xtompok/LED_driver/hw/LED_driver_BOM.ods

Component Count: | 96
Ref | Qnty | Value | Cmp name | Footprint | Description | Vendor
C1, C2, C10, C11, C16, C20, C21, C30, C31, C51, C61, C71, C81, | 13 | 100n | C | Capacitor_SMD:C_0603_1608Metric
C4, C7, | 2 | 27p | C | Capacitor_SMD:C_0603_1608Metric
C5, C6, C8, C13, | 4 | 1u | C | Capacitor_SMD:C_0603_1608Metric
C9, | 1 | 10n | C | Capacitor_SMD:C_0603_1608Metric
C12, | 1 | 2u2 | C | Capacitor_SMD:C_0603_1608Metric
D1, | 1 | BZT52C15 | D_Zener | Diode_SMD:D_SOD-123F | Zener diode
D2, | 1 | STPS160A | D_Schottky | Diode_SMD:D_SMA
D3, | 1 | L_U1 | LED | LED_SMD:LED_PLCC-2 | Light emitting diode
D4, | 1 | L_U2 | LED | LED_SMD:LED_PLCC-2 | Light emitting diode
D5, | 1 | L_TX | LED | LED_SMD:LED_PLCC-2 | Light emitting diode
D6, | 1 | L_RX | LED | LED_SMD:LED_PLCC-2 | Light emitting diode
D7, | 1 | L_VCC | LED | LED_SMD:LED_PLCC-2 | Light emitting diode
D8, | 1 | L_12V | LED | LED_SMD:LED_PLCC-2 | Light emitting diode
J1, | 1 | PROG | Conn_01x05 | Connector_Molex:Molex_KK-254_AE-6410-05A_1x05_P2.54mm_Vertical | Generic connector, single row, 01x05, script generated (kicad-library-utils/schlib/autogen/connector/)
J2, | 1 | LED_STRIPS | Conn_02x03_Counter_Clockwise | Connector_Molex:Molex_Micro-Fit_3.0_43045-0600_2x03_P3.00mm_Horizontal | Generic connector, double row, 02x03, counter clockwise pin numbering scheme (similar to DIP packge numbering), script generated (kicad-library-utils/schlib/autogen/connector/)
J3, | 1 | POWER | Conn_01x03 | Connector_Phoenix_MSTB:PhoenixContact_MSTB_2,5_3-GF-5,08_1x03_P5.08mm_Horizontal_ThreadedFlange | Generic connector, single row, 01x03, script generated (kicad-library-utils/schlib/autogen/connector/)
J4, | 1 | SINGLE_POWER | Conn_01x02 | Connector_PinHeader_2.54mm:PinHeader_1x02_P2.54mm_Vertical | Generic connector, single row, 01x02, script generated (kicad-library-utils/schlib/autogen/connector/)
J5, | 1 | RST | Conn_01x02 | Connector_PinHeader_2.54mm:PinHeader_1x02_P2.54mm_Vertical | Generic connector, single row, 01x02, script generated (kicad-library-utils/schlib/autogen/connector/)
J6, | 1 | RS485_1 | Conn_01x03 | LED_driver:PTSA_1.5_3-3.5-Z_1985205 | Generic connector, single row, 01x03, script generated (kicad-library-utils/schlib/autogen/connector/)
J7, | 1 | RS485_2 | Conn_01x03 | LED_driver:PTSA_1.5_3-3.5-Z_1985205 | Generic connector, single row, 01x03, script generated (kicad-library-utils/schlib/autogen/connector/)
J8, | 1 | I2C | Conn_01x04 | Connector_Molex:Molex_KK-254_AE-6410-04A_1x04_P2.54mm_Vertical | Generic connector, single row, 01x04, script generated (kicad-library-utils/schlib/autogen/connector/)
J9, | 1 | BUTTONS | Conn_02x04_Counter_Clockwise | Connector_Molex:Molex_Micro-Fit_3.0_43045-0800_2x04_P3.00mm_Horizontal | Generic connector, double row, 02x04, counter clockwise pin numbering scheme (similar to DIP packge numbering), script generated (kicad-library-utils/schlib/autogen/connector/)
J10, | 1 | ADC_EXT | Conn_01x04 | Connector_Molex:Molex_KK-254_AE-6410-04A_1x04_P2.54mm_Vertical | Generic connector, single row, 01x04, script generated (kicad-library-utils/schlib/autogen/connector/)
J11, | 1 | LED_EN | Conn_01x02 | Connector_PinHeader_2.54mm:PinHeader_1x02_P2.54mm_Vertical | Generic connector, single row, 01x02, script generated (kicad-library-utils/schlib/autogen/connector/)
Q1, | 1 | SE60P20B | Q_PMOS_GSD | Package_TO_SOT_SMD:TO-252-2 | P-MOSFET transistor, gate/source/drain
Q10, Q20, Q30, | 3 | YJD80G06A | Q_NMOS_GSD | Package_TO_SOT_SMD:TO-252-2 | N-MOSFET transistor, gate/source/drain
R1, R2, R6, R7, R12, | 5 | 10k | R | Resistor_SMD:R_0603_1608Metric
R3, | 1 | 1M | R | Resistor_SMD:R_0603_1608Metric
R4, R23, | 2 | 33k | R | Resistor_SMD:R_0603_1608Metric
R5, | 1 | 150k | R | Resistor_SMD:R_0603_1608Metric
R8, R9, R29 | 3 | 1k5 | R | Resistor_SMD:R_0603_1608Metric
R10, R20, R30, | 3 | 100R | R | Resistor_SMD:R_0603_1608Metric
R11, R21, R31, | 3 | 0.01R | R | Resistor_SMD:R_1206_3216Metric
R24, R25, R26, R27, | 4 | 330R | R | Resistor_SMD:R_0603_1608Metric
R28, R51, R61, R71, R81, | 5 | 4k7 | R | Resistor_SMD:R_0603_1608Metric
R32, | 1 | 560R | R | Resistor_SMD:R_0603_1608Metric
R33, R52, R62, R72, R82, | 5 | 1k | R | Resistor_SMD:R_0603_1608Metric
R34, R36, | 2 | 720R | R | Resistor_SMD:R_0603_1608Metric
R35, | 1 | 120R | R | Resistor_SMD:R_0603_1608Metric
TH1, | 1 | NTCC-22k | Thermistor_NTC | Capacitor_THT:C_Disc_D3.8mm_W2.6mm_P2.50mm | Temperature dependent resistor, negative temperature coefficient
U1, | 1 | MIC5504-3.3YM5 | MIC5504-3.3YM5 | Package_TO_SOT_SMD:SOT-23-5 | 300mA Low-dropout Voltage Regulator, Vout 3.3V, Vin up to 5.5V, SOT-23
U2, | 1 | AP2204K-5.0 | AP2204K-5.0 | Package_TO_SOT_SMD:SOT-23-5 | 150mA low dropout linear regulator, wide input voltage range, 5.0V fixed positive output, SOT-23-5 package
U3, | 1 | STM32F030C8Tx | STM32F030C8Tx | Package_QFP:LQFP-48_7x7mm_P0.5mm | ARM Cortex-M0 MCU, 64KB flash, 8KB RAM, 48MHz, 2.4-3.6V, 39 GPIO, LQFP-48
U4, | 1 | BY25Q16BSTIG | AT25xxx | Package_SO:SOP-8_3.9x4.9mm_P1.27mm | Microchip SPI Serial EEPROM, DIP-8/SOIC-8/TSSOP-8
U5, | 1 | SN65HVD3082EDR | MAX485E | Package_SO:SOP-8_3.9x4.9mm_P1.27mm | Half duplex RS-485/RS-422, 2.5 Mbps, ±15kV electro-static discharge (ESD) protection, no slew-rate, no low-power shutdown, with receiver/driver enable, 32 receiver drive kapacitity, DIP-8 and SOIC-8
U10, U20, U30, | 3 | ZXGD3009E6 | ZXGD3009E6 | Package_TO_SOT_SMD:SOT-23-6 | 2A (peak) Gate driver, 40V, SOT-23-6
U11, U21, U31, | 3 | INA180A2 | custom_INA180 | Package_TO_SOT_SMD:SOT-23-5
Y1, | 1 | 8MHz | Crystal | Crystal:Crystal_HC49-U_Vertical | Two pin crystal
