xtompok/LED_driver/hw/LED_driver3/LED_driver3.kicad_pcb

## KiCad design hw/LED_driver3/LED_driver3.kicad_pcb (2024-09-17)

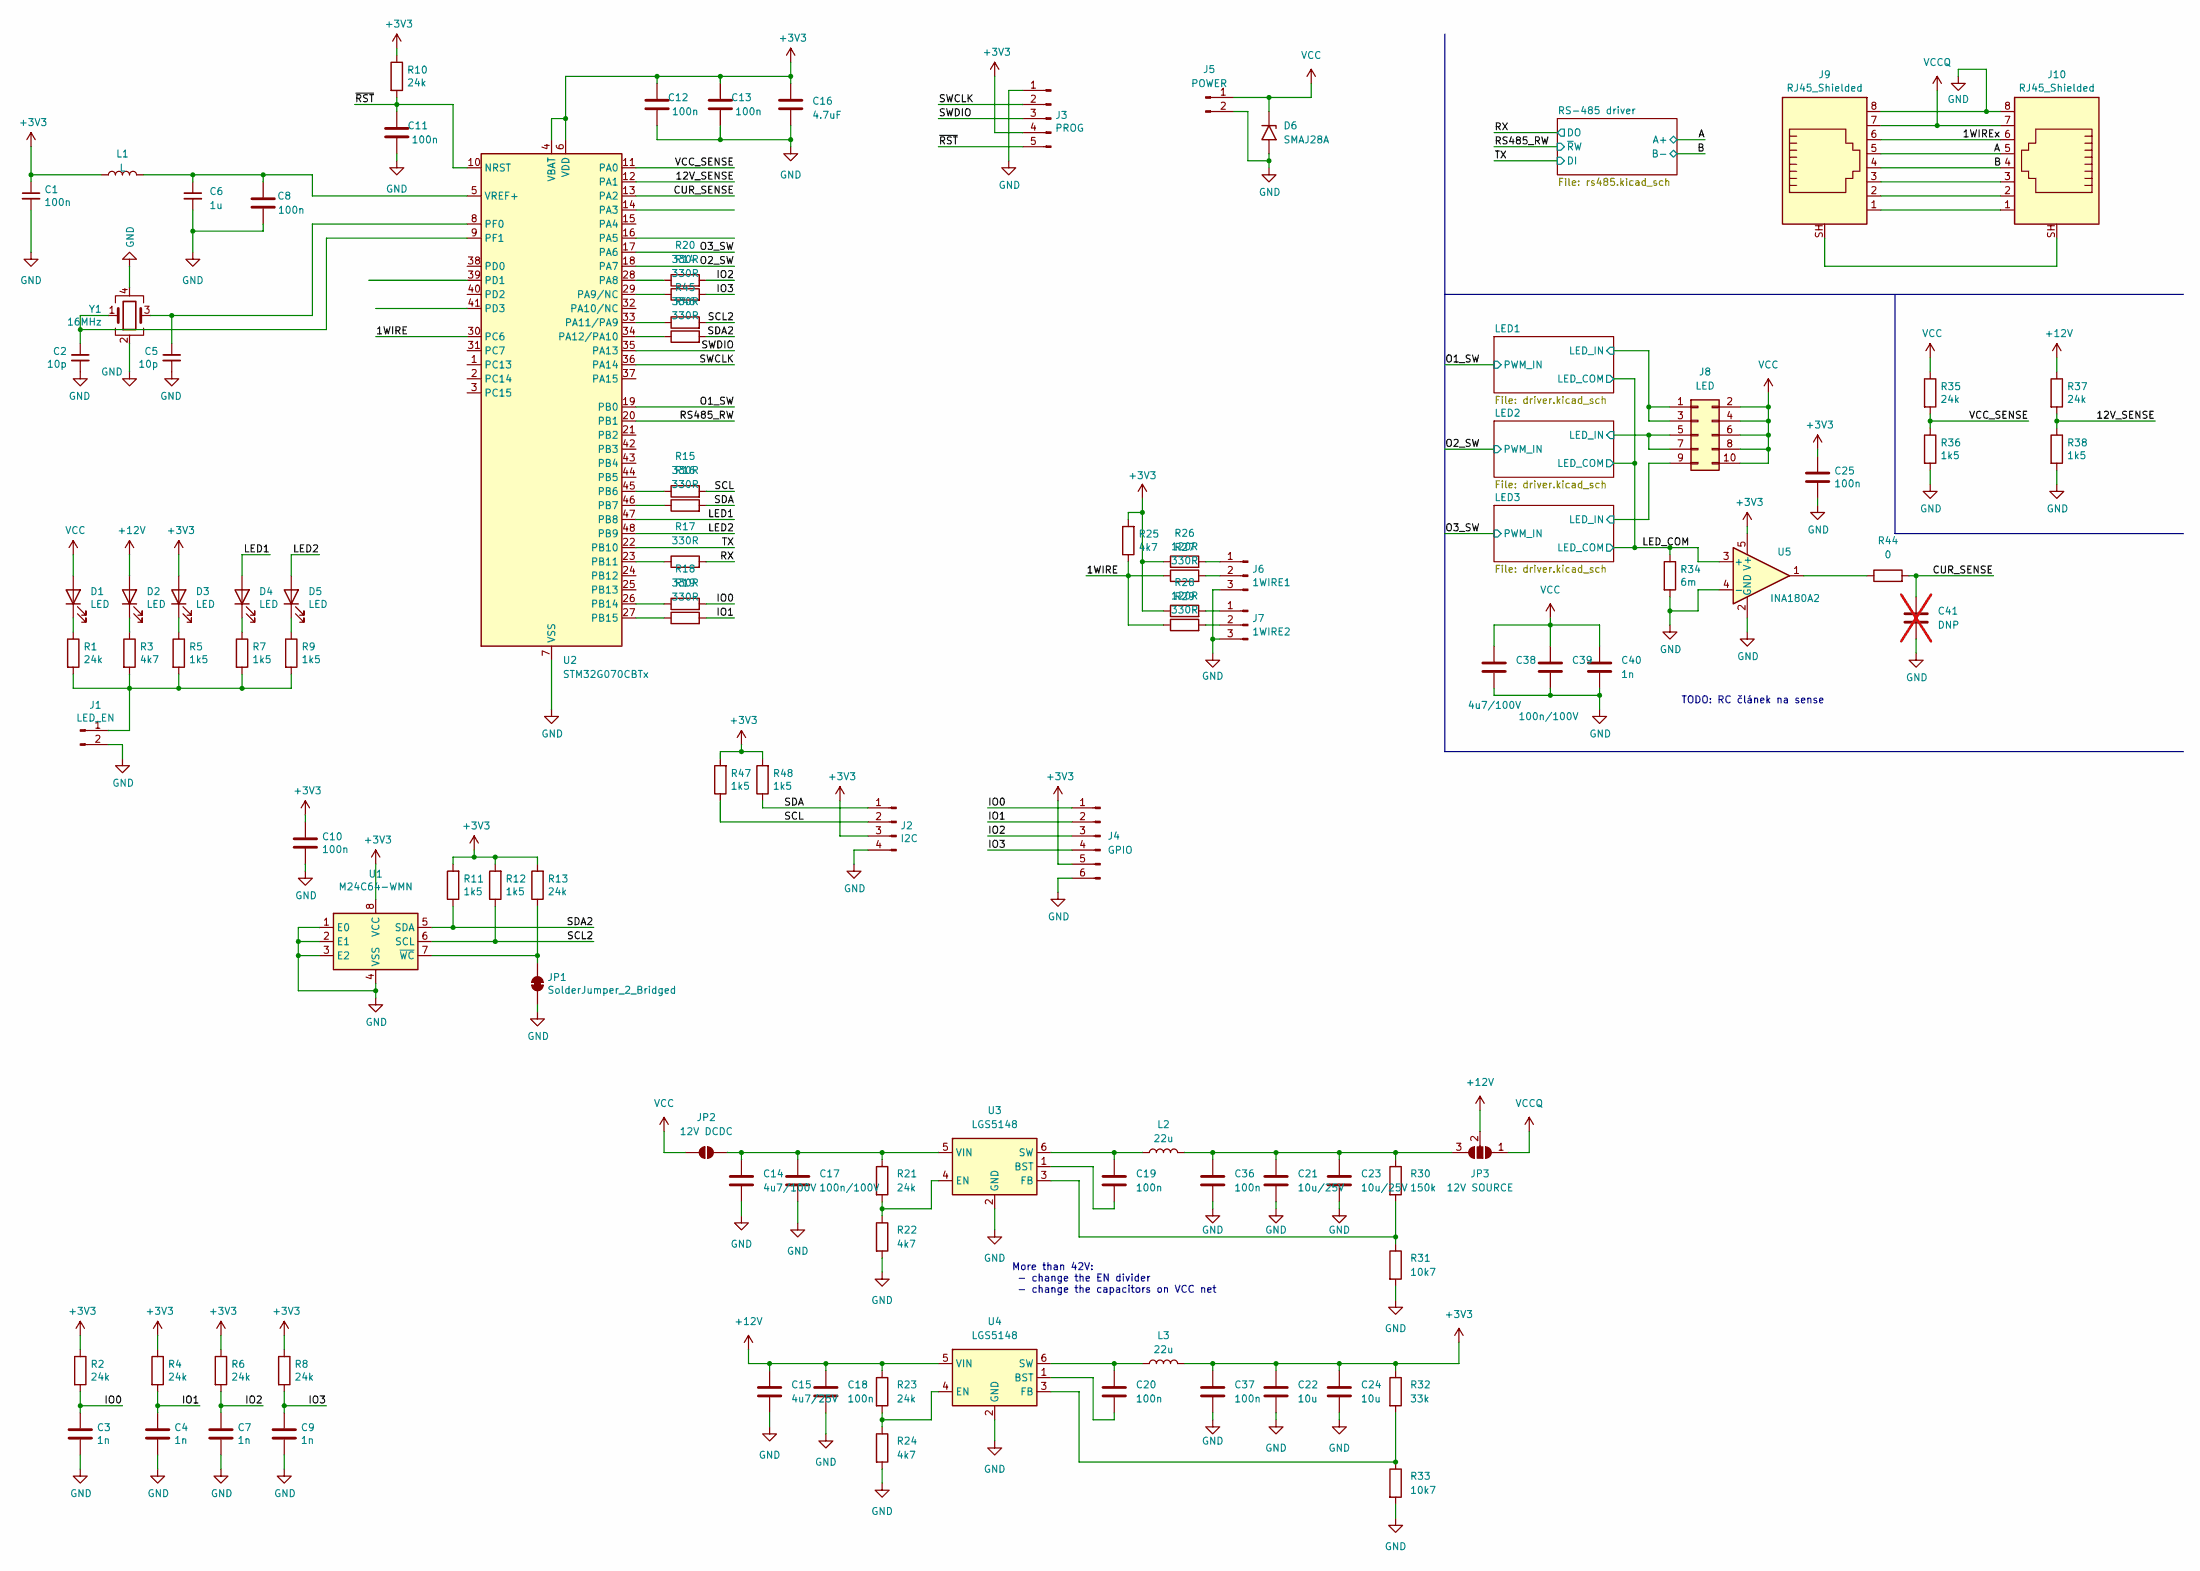
[picture p1: schematic LED_driver3.kicad_sch]

Parts:
C1: 100n; C_0603_1608Metric; Manufacturer_Part_Number CC0603KRX7R9BB104; LCSC C14663
C2, C5: 10p; C_0402_1005Metric; LCSC C32949
C3, C4, C7, C9, C40: 1n; C_0603_1608Metric; LCSC C1588
C6: 1u; C_0805_2012Metric; Manufacturer_Part_Number CL21B105KBFNNNE; LCSC C28323
C8, C10, C11, C12, C13, C18, C19, C20, C25, C36, C37: 100n; C_0603_1608Metric; LCSC C14663
C14, C38: 4u7/100V; C_1206_3216Metric; LCSC C29823
C15: 4u7/25V; C_0805_2012Metric; LCSC C1779
C16: 4.7uF; C_0603_1608Metric; LCSC C19666
C17, C39: 100n/100V; C_0805_2012Metric; LCSC C28233
C21, C23: 10u/25V; C_0805_2012Metric; LCSC C440198
C22, C24: 10u; C_0805_2012Metric; LCSC C440198
C41: DNP; C_0603_1608Metric; not fitted
D1: LED; LED_0603_1608Metric; LCSC C72043
D2, D3, D4, D5: LED; LED_0603_1608Metric
D6: SMAJ28A; D_SMA; LCSC C908775
J1: LED_EN; SolderJumper-2_P1.3mm_Open_TrianglePad1.0x1.5mm
J2: I2C; 15EDGVC-2.5-04P-14
J3: PROG; Molex_KK-254_AE-6410-05A_1x05_P2.54mm_Vertical
J4: GPIO; 15EDGVC-2.5-06P-14
J5: POWER; PhoenixContact_MSTB_2,5_2-GF-5,08_1x02_P5.08mm_Horizontal_T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
J6: 1WIRE1; 15EDGVC-2.5-03P-14
J7: 1WIRE2; 15EDGVC-2.5-03P-14
J8: LED; 15EDGRHCM-THR-3,50-10P-13
J9, J10: RJ45_Shielded; RJJS-88-A22-E1V
JP1: SolderJumper_2_Bridged; SolderJumper-2_P1.3mm_Bridged_Pad1.0x1.5mm
JP2: 12V DCDC; SolderJumper-2_P1.3mm_Open_TrianglePad1.0x1.5mm
JP3: 12V SOURCE; SolderJumper-3_P2.0mm_Open_TrianglePad1.0x1.5mm
L1: L; L_0805_2012Metric; LCSC C88990
L2, L3: 22u; L_Sunlord_SWPA4030S; LCSC C83472
R1, R2, R4, R6, R8, R10, R13, R21, R23, R35, R37: 24k; R_0603_1608Metric; LCSC C23352
R3, R22, R24, R25: 4k7; R_0603_1608Metric; LCSC C23162
R5, R7, R9, R11, R12, R36, R38, R47, R48: 1k5; R_0603_1608Metric; LCSC C22843
R14, R15, R16, R17, R18, R19, R20, R27, R29, R45, R46: 330R; R_0603_1608Metric; LCSC C23138
R26, R28: 120R; R_0603_1608Metric; LCSC C22787
R30: 150k; R_0603_1608Metric
R31, R33: 10k7; R_0603_1608Metric
R32: 33k; R_0603_1608Metric
R34: 6m; R_2512_6332Metric; LCSC C728340
R44: 0; R_0603_1608Metric
U1: M24C64-WMN; SOIC-8_3.9x4.9mm_P1.27mm; LCSC C79988
U2: STM32G070CBTx; LQFP-48_7x7mm_P0.5mm; LCSC C529338
U3, U4: LGS5148; SOT-23-6
U5: INA180A2; SOT-23-5; LCSC C192764
Y1: 16MHz; Crystal_SMD_3225-4Pin_3.2x2.5mm; LCSC C13738

Connections:
+3V3: C1.1, C10.1, C12.1, C13.1, C16.1, C22.1, C24.1, C25.1, C37.1, D3.2 (A), J2.3, J3.4, J4.5, L1.1, L3.2, R2.1, R4.1, R6.1, R8.1, R10.1, R11.2, R12.2, R13.2, R25.2, R26.1, R28.1, R32.1, R47.2, R48.2, U1.8 (VCC), U2.4 (VBAT), U2.6 (VDD), U5.5 (V+); also elsewhere on the board
+12V: C15.1, C18.1, D2.2 (A), JP3.2 (C), R23.1, R37.1, U4.5 (VIN); also elsewhere on the board
/1WIRE: R25.1, R27.1, R29.1, U2.30 (PC6)
/1WIREx: J9.6, J10.6
/12V_SENSE: R37.2, R38.1, U2.12 (PA1)
/A: J9.5, J10.5; also elsewhere on the board
/B: J9.4, J10.4; also elsewhere on the board
/CUR_SENSE: C41.1, R44.2, U2.13 (PA2)
/IO0: C3.2, J4.1, R2.2, R18.2
/IO1: C4.2, J4.2, R4.2, R19.2
/IO2: C7.2, J4.3, R6.2, R20.2
/IO3: C9.2, J4.4, R8.2, R14.2
/LED1: D4.2 (A), U2.47 (PB8)
/LED1/LED_IN: J8.1, J8.3; also elsewhere on the board
/LED2: D5.2 (A), U2.48 (PB9)
/LED2/LED_IN: J8.5, J8.7; also elsewhere on the board
/LED3/LED_IN: J8.9; also elsewhere on the board
/LED_COM: R34.1, U5.3 (+); also elsewhere on the board
/O1_SW: U2.19 (PB0); also elsewhere on the board
/O2_SW: U2.18 (PA7); also elsewhere on the board
/O3_SW: U2.17 (PA6); also elsewhere on the board
/RS485_RW: U2.20 (PB1); also elsewhere on the board
/RX: R17.2; also elsewhere on the board
/SCL: J2.2, R15.2, R47.1
/SCL2: R12.1, R45.2, U1.6 (SCL)
/SDA: J2.1, R16.2, R48.1
/SDA2: R11.1, R46.2, U1.5 (SDA)
/SWCLK: J3.2, U2.36 (PA14)
/SWDIO: J3.3, U2.35 (PA13)
/TX: U2.22 (PB10); also elsewhere on the board
/VCC_SENSE: R35.2, R36.1, U2.11 (PA0)
/~RST: C11.1, J3.5, R10.2, U2.10 (NRST)
GND: C1.2, C2.2, C3.1, C4.1, C5.2, C6.2, C7.1, C8.2, C9.1, C10.2, C11.2, C12.2, C13.2, C14.2, C15.2, C16.2, C17.2, C18.2, C21.2, C22.2, C23.2, C24.2, C25.2, C36.2, C37.2, C38.2, C39.2, C40.2, C41.2, D6.2 (A2), J1.2, J2.4, J3.1, J4.6, J5.2, J6.3, J7.3, J9.8, J10.8, JP1.2 (B), R22.2, R24.2, R31.2, R33.2, R34.2, R36.2, R38.2, U1.1 (E0), U1.2 (E1), U1.3 (E2), U1.4 (VSS), U2.7 (VSS), U3.2 (GND), U4.2 (GND), U5.2 (GND), U5.4 (-), Y1.2, Y1.4; also elsewhere on the board
unnamed: D1.1 (K), R1.1
unnamed: D2.1 (K), R3.1
unnamed: D3.1 (K), R5.1
unnamed: D4.1 (K), R7.1
unnamed: D5.1 (K), R9.1
unnamed: J1.1, R1.2, R3.2, R5.2, R7.2, R9.2
unnamed: J6.1, R26.2
unnamed: J6.2, R27.2
unnamed: J7.1, R28.2
unnamed: J7.2, R29.2
unnamed: J9.1, J10.1
unnamed: J9.2, J10.2
unnamed: J9.3, J10.3
unnamed: J9.SH, J10.SH
unnamed: JP1.1 (A), R13.1, U1.7 (~WC)
unnamed: C14.1, C17.1, JP2.2 (B), R21.1, U3.5 (VIN)
unnamed: C21.1, C23.1, C36.1, JP3.3 (B), L2.2, R30.1
unnamed: R44.1, U5.1
unnamed: R20.1, U2.28 (PA8)
unnamed: R14.1, U2.29 (PA9/NC)
unnamed: R45.1, U2.33 (PA11/PA9)
unnamed: R46.1, U2.34 (PA12/PA10)
unnamed: R15.1, U2.45 (PB6)
unnamed: R16.1, U2.46 (PB7)
unnamed: R17.1, U2.23 (PB11)
unnamed: R18.1, U2.26 (PB14)
unnamed: R19.1, U2.27 (PB15)
unnamed: C5.1, U2.8 (PF0), Y1.3
unnamed: C2.1, U2.9 (PF1), Y1.1
unnamed: C6.1, C8.1, L1.2, U2.5 (VREF+)
unnamed: C19.2, U3.1 (BST)
unnamed: R21.2, R22.1, U3.4 (EN)
unnamed: R30.2, R31.1, U3.3 (FB)
unnamed: C19.1, L2.1, U3.6 (SW)
unnamed: C20.2, U4.1 (BST)
unnamed: R23.2, R24.1, U4.4 (EN)
unnamed: R32.2, R33.1, U4.3 (FB)
unnamed: C20.1, L3.1, U4.6 (SW)
VCC: C38.1, C39.1, C40.1, D1.2 (A), D6.1 (A1), J5.1, J8.2, J8.4, J8.6, J8.8, J8.10, JP2.1 (A), R35.1; also elsewhere on the board
VCCQ: J9.7, J10.7, JP3.1 (A)

Notes on the sheet:
More than 42V: - change the EN divider - change the capacitors on VCC net
TODO: RC článek na sense

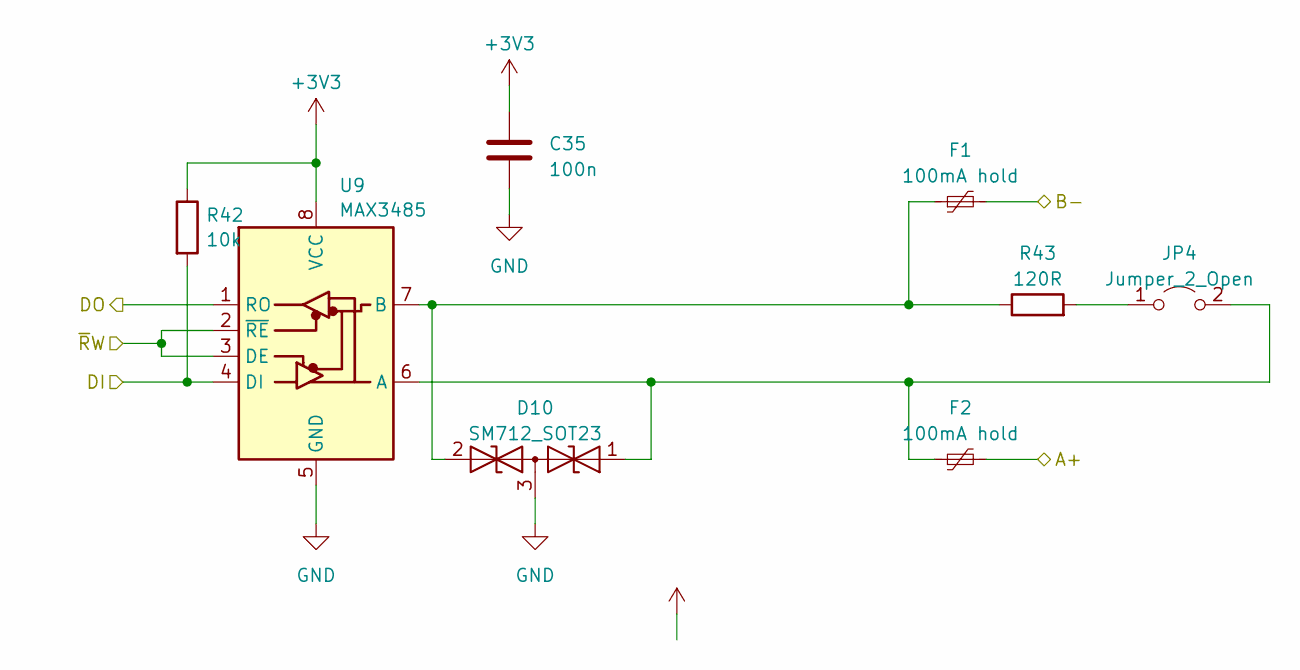
[picture p2: schematic rs485.kicad_sch]

Parts:
C35: 100n; C_0603_1608Metric; LCSC C14663
D10: SM712_SOT23; SOT-23; LCSC C404012
F1, F2: 100mA hold; Fuse_1206_3216Metric; LCSC C70065
JP4: Jumper_2_Open; SolderJumper-2_P1.3mm_Open_TrianglePad1.0x1.5mm; LCSC XXXX
R42: 10k; R_0603_1608Metric; LCSC C25804
R43: 120R; R_0603_1608Metric; LCSC C22787
U9: MAX3485; SOIC-8_3.9x4.9mm_P1.27mm; LCSC C8963

Connections:
+3V3: C35.1, R42.1, U9.8 (VCC); also elsewhere on the board
/A: F2.2; also elsewhere on the board
/B: F1.2; also elsewhere on the board
/RS485_RW: U9.2 (~RE), U9.3 (DE); also elsewhere on the board
/RX: U9.1 (RO); also elsewhere on the board
/TX: R42.2, U9.4 (DI); also elsewhere on the board
GND: C35.2, D10.3 (common), U9.5 (GND); also elsewhere on the board
unnamed: D10.1 (A1), F2.1, JP4.2 (B), U9.6 (A)
unnamed: D10.2 (A2), F1.1, R43.1, U9.7 (B)
unnamed: JP4.1 (A), R43.2

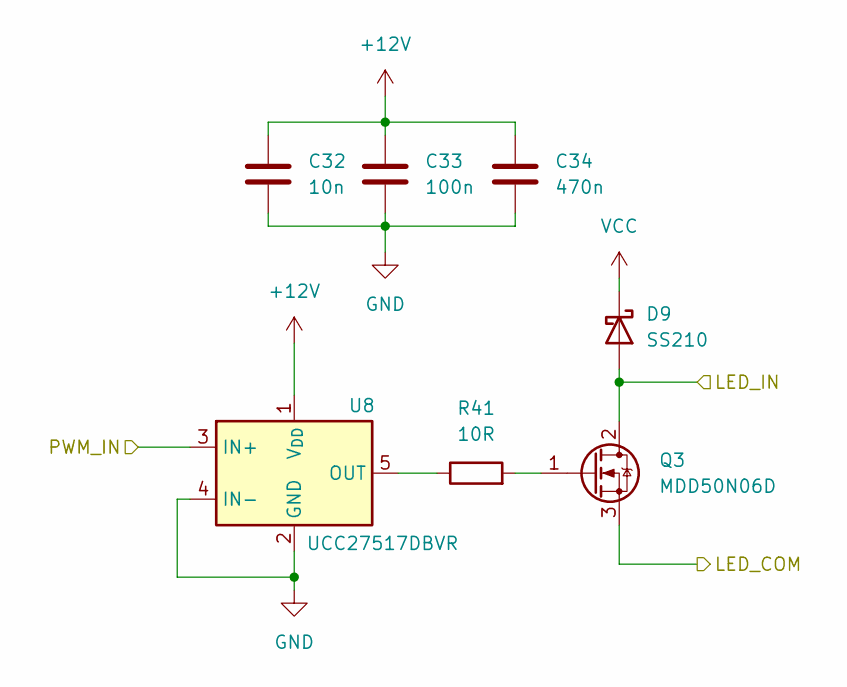
[picture p3: schematic driver.kicad_sch]

Parts:
C32: 10n; C_0603_1608Metric; LCSC C57112
C33: 100n; C_0603_1608Metric; LCSC C14663
C34: 470n; C_0603_1608Metric; LCSC C1623
D9: SS210; D_SMA; LCSC C14996
Q3: MDD50N06D; TO-252-2; LCSC C99395
R41: 10R; R_0603_1608Metric; LCSC C22859
U8: UCC27517DBVR; SOT-23-5

Connections:
+12V: C32.1, C33.1, C34.1, U8.1 (V_{DD}); also elsewhere on the board
/LED3/LED_IN: D9.2 (A), Q3.2 (D); also elsewhere on the board
/LED_COM: Q3.3 (S); also elsewhere on the board
/O3_SW: U8.3 (IN+); also elsewhere on the board
GND: C32.2, C33.2, C34.2, U8.2 (GND), U8.4 (IN-); also elsewhere on the board
unnamed: Q3.1 (G), R41.2
unnamed: R41.1, U8.5 (OUT)
VCC: D9.1 (K); also elsewhere on the board

Parts of its further copies:
C26, C29: 10n; C_0603_1608Metric; LCSC C57112
C27, C30: 100n; C_0603_1608Metric; LCSC C14663
C28, C31: 470n; C_0603_1608Metric; LCSC C1623
D7, D8: SS210; D_SMA; LCSC C14996
Q1, Q2: MDD50N06D; TO-252-2; LCSC C99395
R39, R40: 10R; R_0603_1608Metric; LCSC C22859
U6, U7: UCC27517DBVR; SOT-23-5

Connections of its further copies:
+12V: C26.1, C27.1, C28.1, C29.1, C30.1, C31.1, U6.1 (V_{DD}), U7.1 (V_{DD}); also elsewhere on the board
/LED1/LED_IN: D7.2 (A), Q1.2 (D); also elsewhere on the board
/LED2/LED_IN: D8.2 (A), Q2.2 (D); also elsewhere on the board
/LED_COM: Q1.3 (S), Q2.3 (S); also elsewhere on the board
/O1_SW: U6.3 (IN+); also elsewhere on the board
/O2_SW: U7.3 (IN+); also elsewhere on the board
GND: C26.2, C27.2, C28.2, C29.2, C30.2, C31.2, U6.2 (GND), U6.4 (IN-), U7.2 (GND), U7.4 (IN-); also elsewhere on the board
unnamed: Q1.1 (G), R39.2
unnamed: Q2.1 (G), R40.2
unnamed: R39.1, U6.5 (OUT)
unnamed: R40.1, U7.5 (OUT)
VCC: D7.1 (K), D8.1 (K); also elsewhere on the board

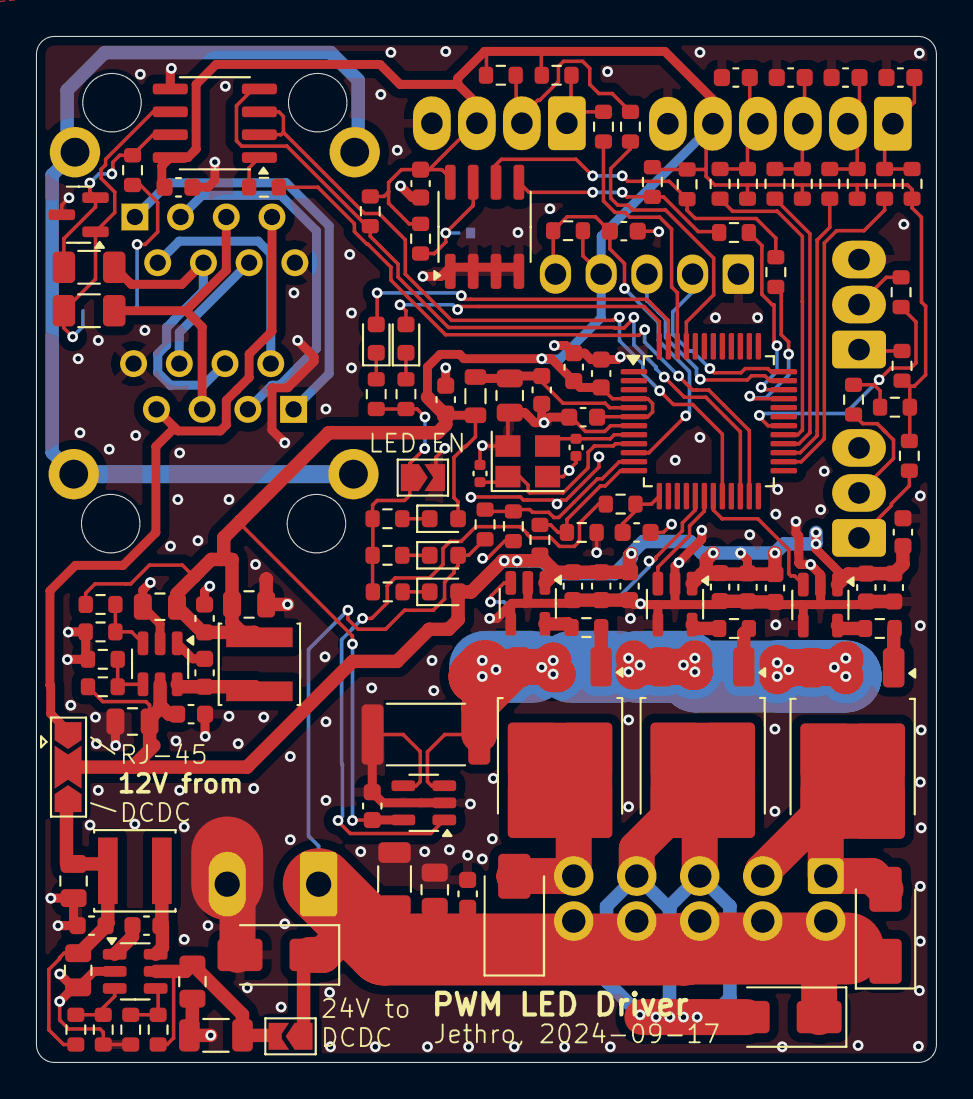
[picture p4: board LED_driver3.kicad_pcb from above]

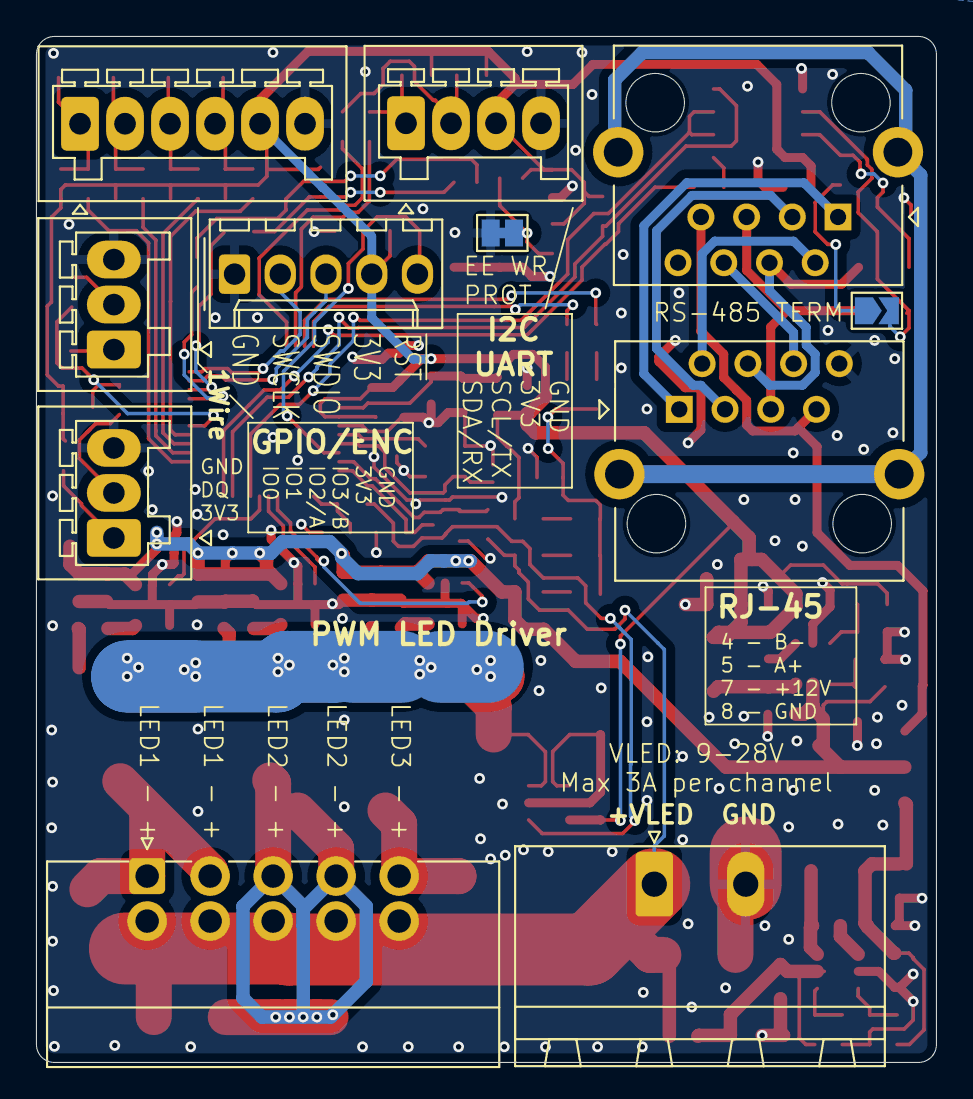
[picture p5: board LED_driver3.kicad_pcb from below]

Board: 2 copper layers, 50.0 x 57.0 mm, 131 parts (11 on the bottom side), 82 nets.
