xtompok/LED_driver/hw/LED_driver2/LED_driver2.kicad_pcb

## KiCad design hw/LED_driver2/LED_driver2.kicad_pcb (2021-05-24)

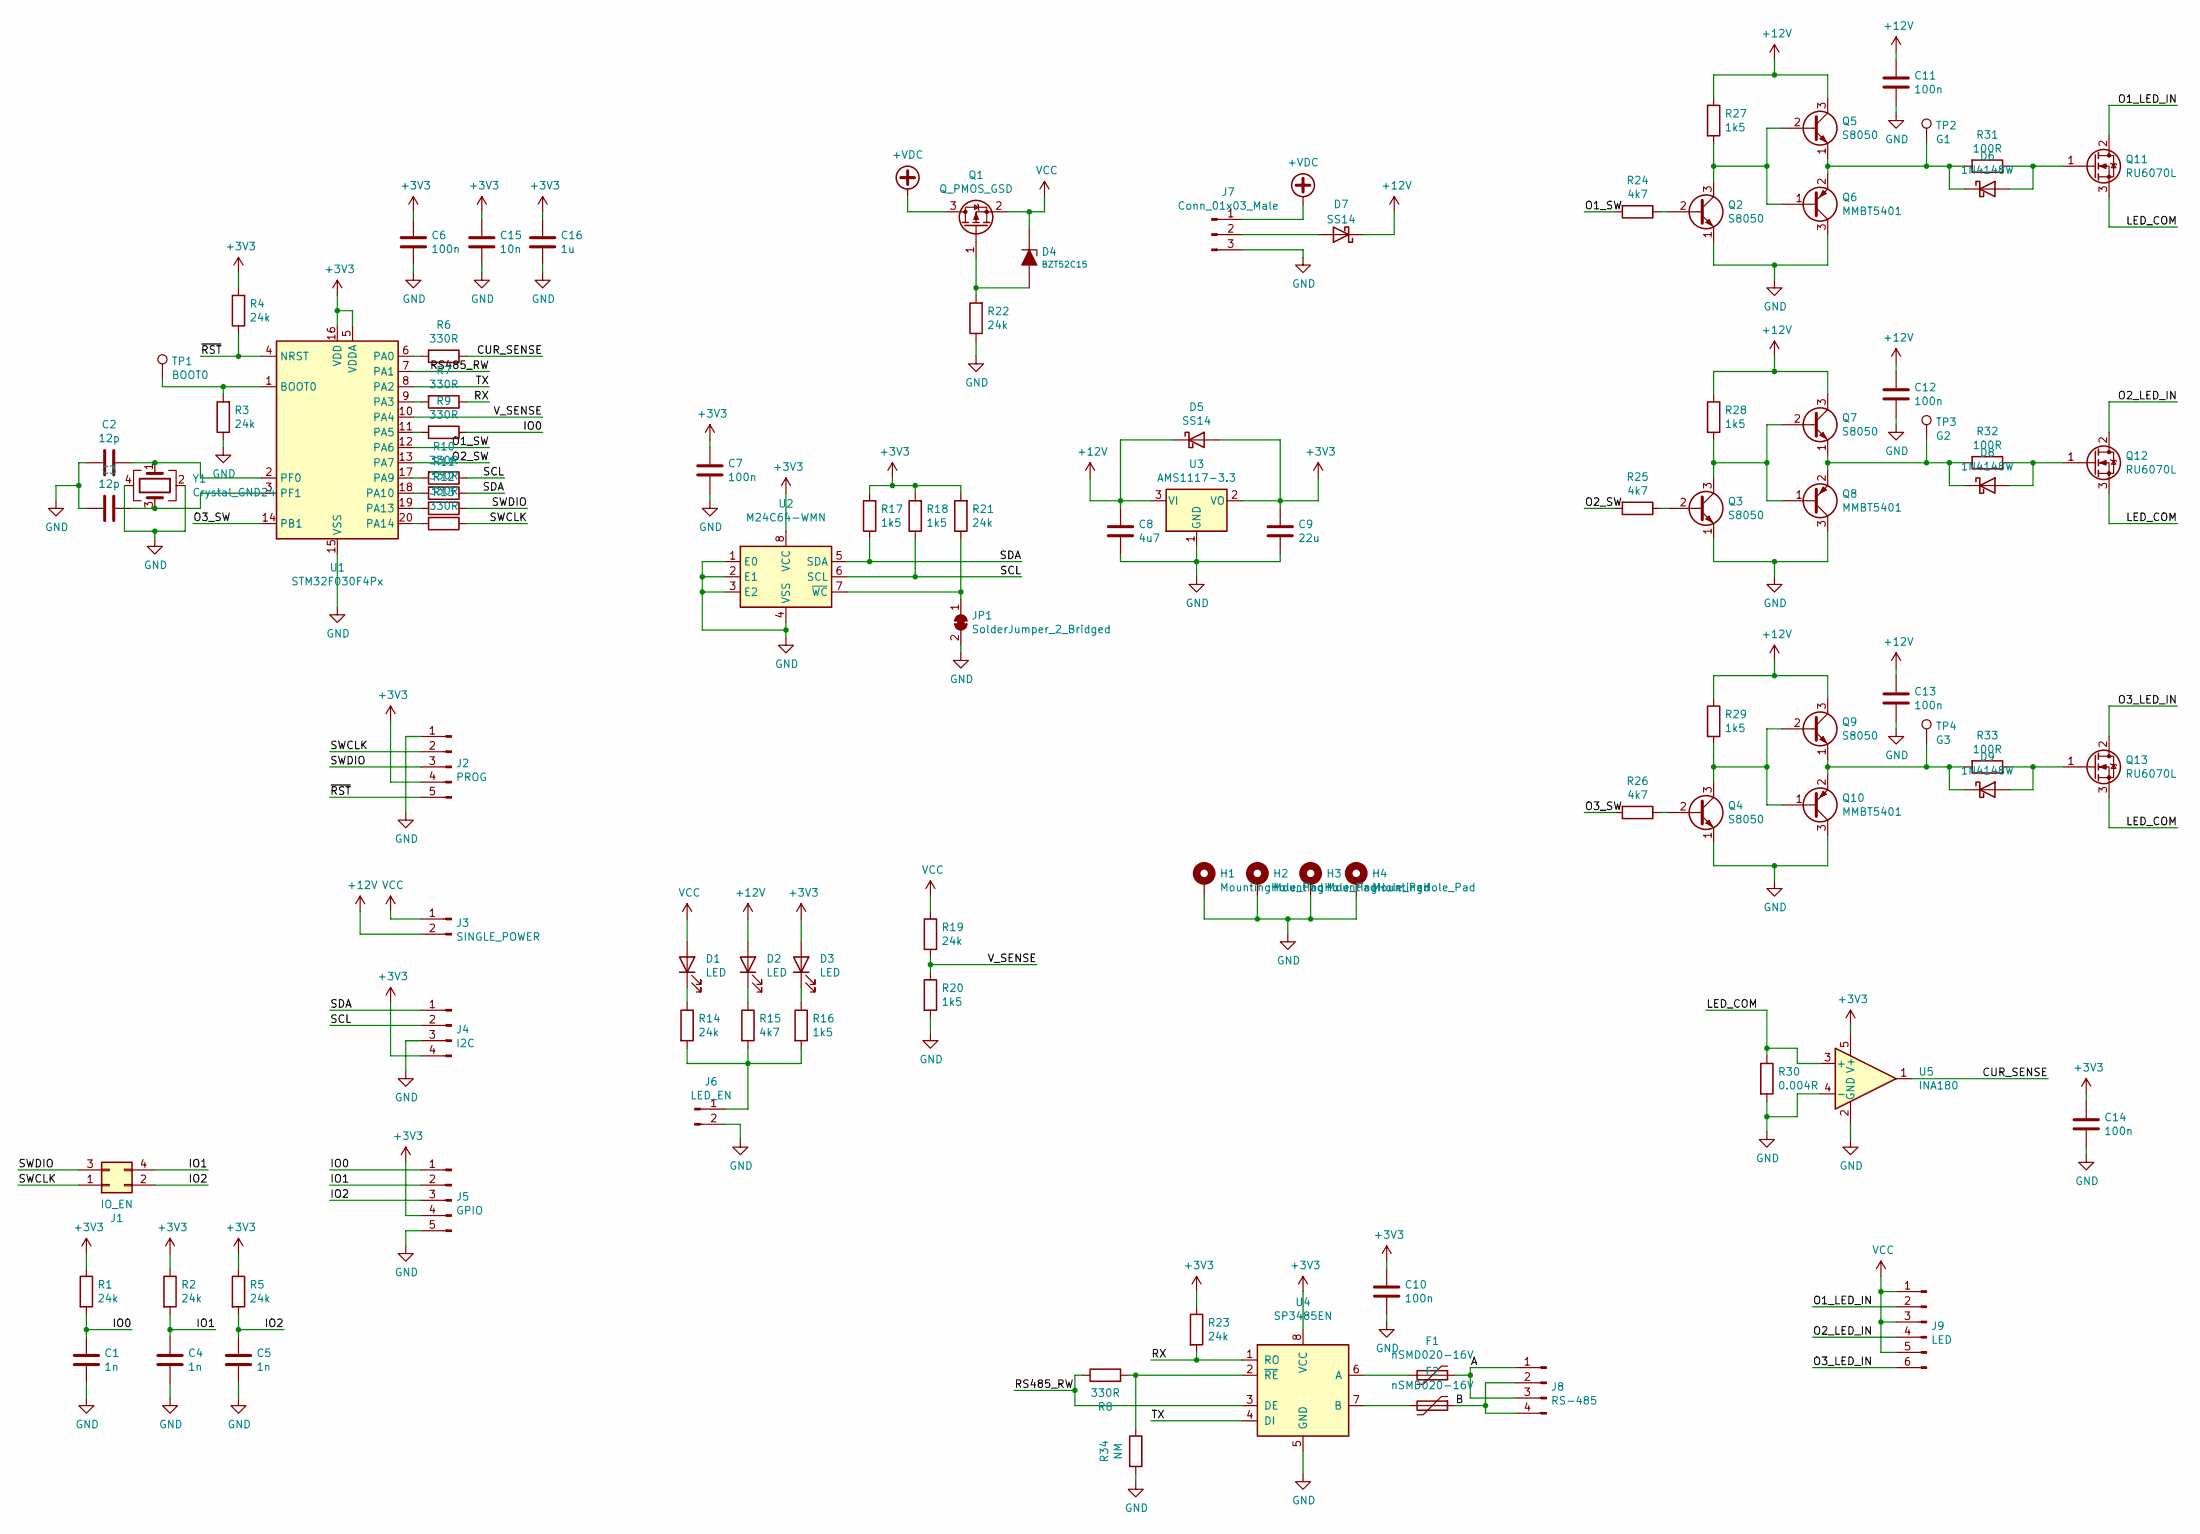
[picture p6: schematic LED_driver2.sch]

Parts:
C1: 1n; C_0603_1608Metric; LCSC C1588
C2: 12p; C_0603_1608Metric; LCSC C38523
C3: 12p; C_0603_1608Metric
C4, C5: 1n; C_0603_1608Metric
C6, C7, C10: 100n; C_0603_1608Metric
C8: 4u7; C_0603_1608Metric; LCSC C19666
C9: 22u; C_0603_1608Metric; LCSC C59461
C11: 100n; R_0603_1608Metric; LCSC C14663
C12, C13: 100n; R_0603_1608Metric
C14: 100n; C_0603_1608Metric; LCSC C14663
C15: 10n; C_0603_1608Metric; LCSC C57112
C16: 1u; C_0603_1608Metric; LCSC C15849
D1: LED; LED_0603_1608Metric; LCSC C72043
D2, D3: LED; LED_0603_1608Metric
D4: BZT52C15; D_SOD-123
D5: SS14; D_SMA
D6, D8, D9: 1N4148W; D_SOD-123; LCSC C81598
D7: SS14; D_SMA; LCSC C2480
F1, F2: nSMD020-16V; Fuse_1206_3216Metric
H1, H2, H3, H4: MountingHole_Pad; MountingHole_3.2mm_M3_Pad_Via
J1: IO_EN; PinHeader_2x02_P2.54mm_Vertical
J2: PROG; Molex_KK-254_AE-6410-05A_1x05_P2.54mm_Vertical
J3: SINGLE_POWER; PinHeader_2x01_P2.54mm_Vertical
J4: I2C; Molex_KK-254_AE-6410-04A_1x04_P2.54mm_Vertical
J5: GPIO; PTSA_1.5_5-3.5-Z_1985221
J6: LED_EN; PinHeader_1x02_P2.54mm_Vertical
J7: Conn_01x03_Male; PhoenixContact_MSTB_2,5_3-GF-5,08_1x03_P5.08mm_Horizontal_T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
J8: RS-485; PTSA_1.5_4-3.5-Z-1985218
J9: LED; PTSA_1.5_6-3.5-Z-1985234
JP1: SolderJumper_2_Bridged; SolderJumper-2_P1.3mm_Bridged_Pad1.0x1.5mm
Q1: Q_PMOS_GSD; TO-252-2
Q2, Q3, Q5, Q7, Q9: S8050; SOT-23
Q4: S8050; SOT-23; LCSC C2146
Q6, Q8: MMBT5401; SOT-23
Q10: MMBT5401; SOT-23; LCSC C8326
Q11, Q12, Q13: RU6070L; TO-252-2
R1, R2, R3, R5, R14, R19, R21, R22, R23: 24k; R_0603_1608Metric
R4: 24k; R_0603_1608Metric; LCSC C23352
R6: 330R; R_0603_1608Metric; LCSC C23138
R7, R8, R9, R10, R11, R12, R13: 330R; R_0603_1608Metric
R15, R25, R26: 4k7; R_0603_1608Metric
R16, R18, R20, R27, R28, R29: 1k5; R_0603_1608Metric
R17: 1k5; R_0603_1608Metric; LCSC C22843
R24: 4k7; R_0603_1608Metric; LCSC C23162
R30: 0.004R; R_2512_6332Metric
R31: 100R; R_0603_1608Metric; LCSC C22775
R32, R33: 100R; R_0603_1608Metric
R34: NM; R_0603_1608Metric
TP1: BOOT0; TestPoint_THTPad_D2.0mm_Drill1.0mm
TP2: G1; TestPoint_THTPad_D1.0mm_Drill0.5mm
TP3: G2; TestPoint_THTPad_D1.0mm_Drill0.5mm
TP4: G3; TestPoint_THTPad_D1.0mm_Drill0.5mm
U1: STM32F030F4Px; TSSOP-20_4.4x6.5mm_P0.65mm
U2: M24C64-WMN; SOIC-8_3.9x4.9mm_P1.27mm; LCSC C79988
U3: AMS1117-3.3; SOT-223-3_TabPin2; LCSC C6186
U4: SP3485EN; SOIC-8_3.9x4.9mm_P1.27mm; LCSC C8963
U5: INA180; SOT-23-5
Y1: Crystal_GND24; Crystal_SMD_3225-4Pin_3.2x2.5mm; LCSC C13738

Connections:
+3V3: C6.1, C7.1, C9.1, C10.1, C14.1, C15.1, C16.1, D3.2 (A), D5.2 (A), J2.4, J4.4, J5.4, R1.1, R2.1, R4.2, R5.1, R17.2, R18.2, R21.2, R23.1, U1.5 (VDDA), U1.16 (VDD), U2.8 (VCC), U3.2 (VO), U4.8 (VCC), U5.5 (V+)
+12V: C8.1, C11.1, C12.1, C13.1, D2.2 (A), D5.1 (K), D7.1 (K), J3.2, Q5.3 (C), Q7.3 (C), Q9.3 (C), R27.1, R28.1, R29.1, U3.3 (VI)
+VDC: J7.1, Q1.3 (D)
/A: F1.1, J8.1, J8.3
/B: F2.1, J8.2, J8.4
/CUR_SENSE: R6.1, U5.1
/IO0: C1.2, J5.1, R1.2, R9.1
/IO1: C4.2, J1.4, J5.2, R2.2
/IO2: C5.2, J1.2, J5.3, R5.2
/LED_COM: Q11.3 (S), Q12.3 (S), Q13.3 (S), R30.1, U5.3 (+)
/O1_LED_IN: J9.2, Q11.2 (D)
/O1_SW: R24.2, U1.12 (PA6)
/O2_LED_IN: J9.4, Q12.2 (D)
/O2_SW: R25.2, U1.13 (PA7)
/O3_LED_IN: J9.6, Q13.2 (D)
/O3_SW: R26.2, U1.14 (PB1)
/RS485_RW: R8.1, U1.7 (PA1), U4.3 (DE)
/RX: R7.1, R23.2, U4.1 (RO)
/SCL: J4.2, R10.1, R18.1, U2.6 (SCL)
/SDA: J4.1, R11.1, R17.1, U2.5 (SDA)
/SWCLK: J1.1, J2.2, R13.1
/SWDIO: J1.3, J2.3, R12.1
/TX: U1.8 (PA2), U4.4 (DI)
/V_SENSE: R19.2, R20.1, U1.10 (PA4)
/~RST: J2.5, R4.1, U1.4 (NRST)
GND: C1.1, C2.2, C3.2, C4.1, C5.1, C6.2, C7.2, C8.2, C9.2, C10.2, C11.2, C12.2, C13.2, C14.2, C15.2, C16.2, H1.1, H2.1, H3.1, H4.1, J2.1, J4.3, J5.5, J6.2, J7.3, JP1.2 (B), Q2.1 (E), Q3.1 (E), Q4.1 (E), Q6.3 (C), Q8.3 (C), Q10.3 (C), R3.1, R20.2, R22.1, R30.2, R34.2, U1.15 (VSS), U2.1 (E0), U2.2 (E1), U2.3 (E2), U2.4 (VSS), U3.1 (GND), U4.5 (GND), U5.2 (GND), U5.4 (-), Y1.2, Y1.4
unnamed: C2.1, U1.2 (PF0), Y1.1
unnamed: C3.1, U1.3 (PF1), Y1.3
unnamed: D1.1 (K), R14.1
unnamed: D2.1 (K), R15.1
unnamed: D3.1 (K), R16.1
unnamed: D4.1 (A), Q1.1 (G), R22.2
unnamed: D6.1 (K), Q5.1 (E), Q6.2 (E), R31.2, TP2.1
unnamed: D6.2 (A), Q11.1 (G), R31.1
unnamed: D7.2 (A), J7.2
unnamed: D8.1 (K), Q7.1 (E), Q8.2 (E), R32.2, TP3.1
unnamed: D8.2 (A), Q12.1 (G), R32.1
unnamed: D9.1 (K), Q9.1 (E), Q10.2 (E), R33.2, TP4.1
unnamed: D9.2 (A), Q13.1 (G), R33.1
unnamed: F1.2, U4.6 (A)
unnamed: F2.2, U4.7 (B)
unnamed: J6.1, R14.2, R15.2, R16.2
unnamed: JP1.1 (A), R21.1, U2.7 (~WC)
unnamed: Q2.2 (B), R24.1
unnamed: Q2.3 (C), Q5.2 (B), Q6.1 (B), R27.2
unnamed: Q3.2 (B), R25.1
unnamed: Q3.3 (C), Q7.2 (B), Q8.1 (B), R28.2
unnamed: Q4.2 (B), R26.1
unnamed: Q4.3 (C), Q9.2 (B), Q10.1 (B), R29.2
unnamed: R3.2, TP1.1, U1.1 (BOOT0)
unnamed: R6.2, U1.6 (PA0)
unnamed: R7.2, U1.9 (PA3)
unnamed: R9.2, U1.11 (PA5)
unnamed: R10.2, U1.17 (PA9)
unnamed: R11.2, U1.18 (PA10)
unnamed: R12.2, U1.19 (PA13)
unnamed: R13.2, U1.20 (PA14)
unnamed: R8.2, R34.1, U4.2 (~RE~)
VCC: D1.2 (A), D4.2 (K), J3.1, J9.1, J9.3, J9.5, Q1.2 (S), R19.1

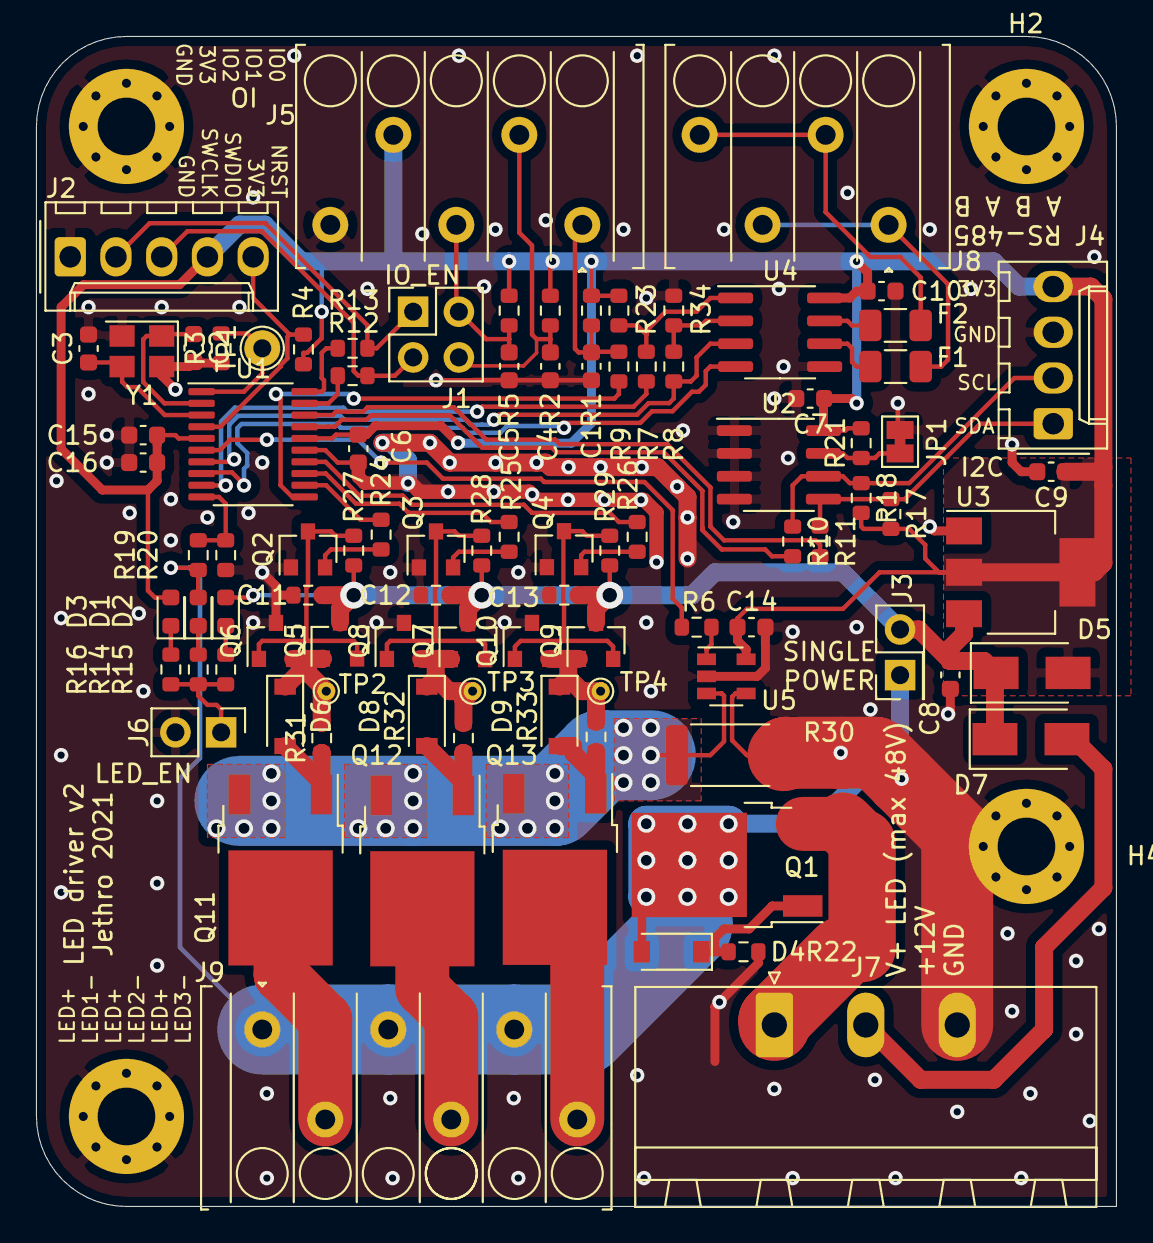
[picture p7: board LED_driver2.kicad_pcb from above]

Board: 2 copper layers, 60.0 x 65.0 mm, 98 parts (0 on the bottom side), 59 nets.
