xtompok/LED_driver/hw/LED_driver.kicad_pcb

## KiCad design hw/LED_driver.kicad_pcb (2020-03-21)

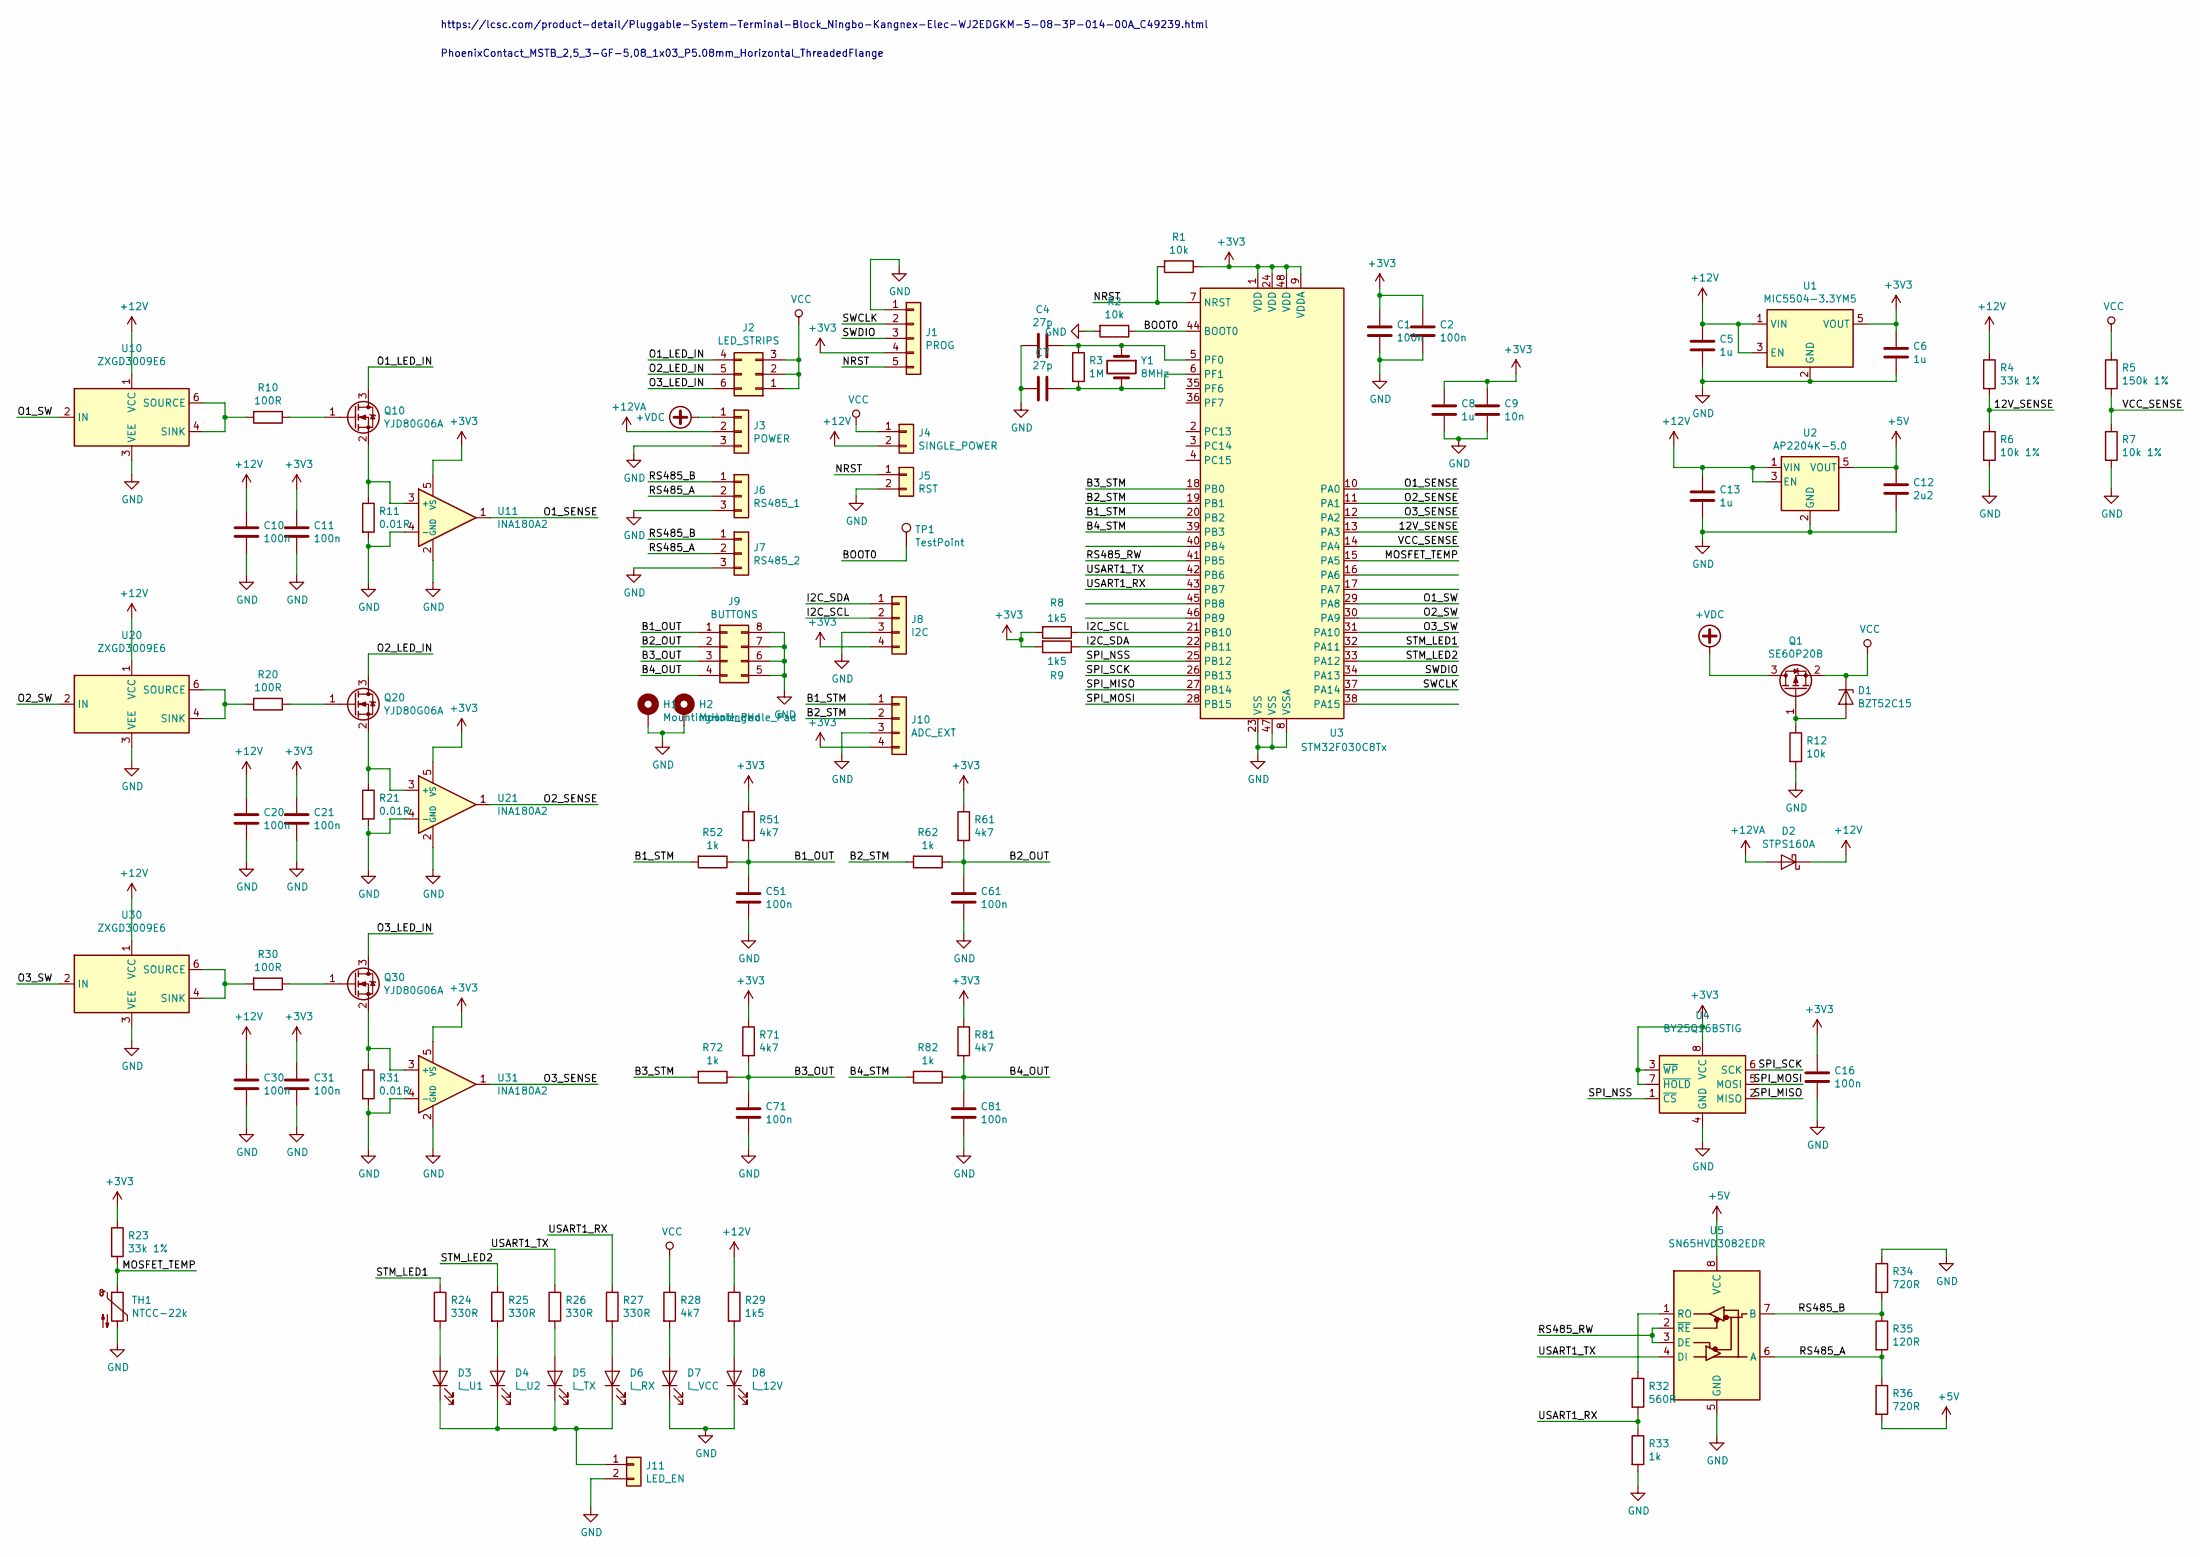
[picture p8: schematic LED_driver.sch]

Parts:
C1, C2, C10, C11, C16, C20, C21, C30, C31, C51, C61, C71, C81: 100n; C_0603_1608Metric
C4, C7: 27p; C_0603_1608Metric
C5, C6, C8, C13: 1u; C_0603_1608Metric
C9: 10n; C_0603_1608Metric
C12: 2u2; C_0603_1608Metric
D1: BZT52C15; D_SOD-123F
D2: STPS160A; D_SMA
D3: L_U1; LED_PLCC-2
D4: L_U2; LED_PLCC-2
D5: L_TX; LED_PLCC-2
D6: L_RX; LED_PLCC-2
D7: L_VCC; LED_PLCC-2
D8: L_12V; LED_PLCC-2
H1, H2: MountingHole_Pad; MountingHole_3.2mm_M3_Pad_Via
J1: PROG; Molex_KK-254_AE-6410-05A_1x05_P2.54mm_Vertical
J2: LED_STRIPS; Molex_Micro-Fit_3.0_43045-0600_2x03_P3.00mm_Horizontal
J3: POWER; PhoenixContact_MSTB_2,5_3-GF-5,08_1x03_P5.08mm_Horizontal_T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
J4: SINGLE_POWER; PinHeader_1x02_P2.54mm_Vertical
J5: RST; PinHeader_1x02_P2.54mm_Vertical
J6: RS485_1; PTSA_1.5_3-3.5-Z_1985205
J7: RS485_2; PTSA_1.5_3-3.5-Z_1985205
J8: I2C; Molex_KK-254_AE-6410-04A_1x04_P2.54mm_Vertical
J9: BUTTONS; Molex_Micro-Fit_3.0_43045-0800_2x04_P3.00mm_Horizontal
J10: ADC_EXT; Molex_KK-254_AE-6410-04A_1x04_P2.54mm_Vertical
J11: LED_EN; PinHeader_1x02_P2.54mm_Vertical
Q1: SE60P20B; TO-252-2
Q10, Q20, Q30: YJD80G06A; TO-252-2
R1, R2, R12: 10k; R_0603_1608Metric
R3: 1M; R_0603_1608Metric
R4, R23: 33k 1%; R_0603_1608Metric
R5: 150k 1%; R_0603_1608Metric
R6, R7: 10k 1%; R_0603_1608Metric
R8, R9, R29: 1k5; R_0603_1608Metric
R10, R20, R30: 100R; R_0603_1608Metric
R11, R21, R31: 0.01R; R_1206_3216Metric
R24, R25, R26, R27: 330R; R_0603_1608Metric
R28, R51, R61, R71, R81: 4k7; R_0603_1608Metric
R32: 560R; R_0603_1608Metric
R33, R52, R62, R72, R82: 1k; R_0603_1608Metric
R34, R36: 720R; R_0603_1608Metric
R35: 120R; R_0603_1608Metric
TH1: NTCC-22k; C_Disc_D3.8mm_W2.6mm_P2.50mm
TP1: TestPoint; TestPoint_THTPad_D2.0mm_Drill1.0mm
U1: MIC5504-3.3YM5; SOT-23-5
U2: AP2204K-5.0; SOT-23-5
U3: STM32F030C8Tx; LQFP-48_7x7mm_P0.5mm
U4: BY25Q16BSTIG; SOP-8_3.9x4.9mm_P1.27mm
U5: SN65HVD3082EDR; SOP-8_3.9x4.9mm_P1.27mm
U10, U20, U30: ZXGD3009E6; SOT-23-6
U11, U21, U31: INA180A2; SOT-23-5
Y1: 8MHz; Crystal_HC49-U_Vertical

Connections:
+3V3: C1.1, C2.1, C6.1, C8.1, C9.1, C11.1, C16.1, C21.1, C31.1, J1.4, J8.4, J10.4, R1.1, R8.2, R9.2, R23.1, R51.1, R61.1, R71.1, R81.1, U1.5 (VOUT), U3.1 (VDD), U3.9 (VDDA), U3.24 (VDD), U3.48 (VDD), U4.3 (~WP), U4.7 (~HOLD), U4.8 (VCC), U11.5 (VS), U21.5 (VS), U31.5 (VS)
+5V: C12.1, R36.2, U2.5 (VOUT), U5.8 (VCC)
+12V: C5.1, C10.1, C13.1, C20.1, C30.1, D2.1 (K), J4.2, R4.1, R29.1, U1.1 (VIN), U1.3 (EN), U2.1 (VIN), U2.3 (EN), U10.1 (VCC), U20.1 (VCC), U30.1 (VCC)
+12VA: D2.2 (A), J3.2
+VDC: J3.1, Q1.3 (D)
/12V_SENSE: R4.2, R6.1, U3.13 (PA3)
/B1_OUT: C51.1, J9.1, R51.2, R52.1
/B1_STM: J10.1, R52.2, U3.20 (PB2)
/B2_OUT: C61.1, J9.2, R61.2, R62.1
/B2_STM: J10.2, R62.2, U3.19 (PB1)
/B3_OUT: C71.1, J9.3, R71.2, R72.1
/B3_STM: R72.2, U3.18 (PB0)
/B4_OUT: C81.1, J9.4, R81.2, R82.1
/B4_STM: R82.2, U3.39 (PB3)
/BOOT0: R2.1, TP1.1, U3.44 (BOOT0)
/I2C_SCL: J8.2, R8.1, U3.21 (PB10)
/I2C_SDA: J8.1, R9.1, U3.22 (PB11)
/MOSFET_TEMP: R23.2, TH1.1, U3.15 (PA5)
/NRST: J1.5, J5.1, R1.2, U3.7 (NRST)
/O1_LED_IN: J2.4, Q10.3 (D)
/O1_SENSE: U3.10 (PA0), U11.1
/O1_SW: U3.29 (PA8), U10.2 (IN)
/O2_LED_IN: J2.5, Q20.3 (D)
/O2_SENSE: U3.11 (PA1), U21.1
/O2_SW: U3.30 (PA9), U20.2 (IN)
/O3_LED_IN: J2.6, Q30.3 (D)
/O3_SENSE: U3.12 (PA2), U31.1
/O3_SW: U3.31 (PA10), U30.2 (IN)
/RS485_A: J6.2, J7.2, R35.2, R36.1, U5.6 (A)
/RS485_B: J6.1, J7.1, R34.2, R35.1, U5.7 (B)
/RS485_RW: U3.41 (PB5), U5.2 (~RE), U5.3 (DE)
/SPI_MISO: U3.27 (PB14), U4.2 (MISO)
/SPI_MOSI: U3.28 (PB15), U4.5 (MOSI)
/SPI_NSS: U3.25 (PB12), U4.1 (~CS)
/SPI_SCK: U3.26 (PB13), U4.6 (SCK)
/STM_LED1: R24.1, U3.32 (PA11)
/STM_LED2: R25.1, U3.33 (PA12)
/SWCLK: J1.2, U3.37 (PA14)
/SWDIO: J1.3, U3.34 (PA13)
/USART1_RX: R27.1, R32.2, R33.1, U3.43 (PB7)
/USART1_TX: R26.1, U3.42 (PB6), U5.4 (DI)
/VCC_SENSE: R5.2, R7.1, U3.14 (PA4)
GND: C1.2, C2.2, C4.2, C5.2, C6.2, C7.2, C8.2, C9.2, C10.2, C11.2, C12.2, C13.2, C16.2, C20.2, C21.2, C30.2, C31.2, C51.2, C61.2, C71.2, C81.2, D7.1 (K), D8.1 (K), H1.1, H2.1, J1.1, J3.3, J5.2, J6.3, J7.3, J8.3, J9.5, J9.6, J9.7, J9.8, J10.3, J11.2, R2.2, R6.2, R7.2, R11.2, R12.2, R21.2, R31.2, R33.2, R34.1, TH1.2, U1.2 (GND), U2.2 (GND), U3.8 (VSSA), U3.23 (VSS), U3.47 (VSS), U4.4 (GND), U5.5 (GND), U10.3 (VEE), U11.2 (GND), U11.4 (-), U20.3 (VEE), U21.2 (GND), U21.4 (-), U30.3 (VEE), U31.2 (GND), U31.4 (-)
unnamed: C4.1, R3.1, U3.5 (PF0), Y1.1
unnamed: C7.1, R3.2, U3.6 (PF1), Y1.2
unnamed: D1.2 (A), Q1.1 (G), R12.1
unnamed: D3.1 (K), D4.1 (K), D5.1 (K), D6.1 (K), J11.1
unnamed: D3.2 (A), R24.2
unnamed: D4.2 (A), R25.2
unnamed: D5.2 (A), R26.2
unnamed: D6.2 (A), R27.2
unnamed: D7.2 (A), R28.2
unnamed: D8.2 (A), R29.2
unnamed: Q10.1 (G), R10.1
unnamed: Q10.2 (S), R11.1, U11.3 (+)
unnamed: Q20.1 (G), R20.1
unnamed: Q20.2 (S), R21.1, U21.3 (+)
unnamed: Q30.1 (G), R30.1
unnamed: Q30.2 (S), R31.1, U31.3 (+)
unnamed: R10.2, U10.4 (SINK), U10.6 (SOURCE)
unnamed: R20.2, U20.4 (SINK), U20.6 (SOURCE)
unnamed: R30.2, U30.4 (SINK), U30.6 (SOURCE)
unnamed: R32.1, U5.1 (RO)
VCC: D1.1 (K), J2.1, J2.2, J2.3, J4.1, Q1.2 (S), R5.1, R28.1

Notes on the sheet:
https://lcsc.com/product-detail/Pluggable-System-Terminal-Block_Ningbo-Kangnex-Elec-WJ2EDGKM-5-08-3P-014-00A_C49239.html
PhoenixContact_MSTB_2,5_3-GF-5,08_1x03_P5.08mm_Horizontal_ThreadedFlange

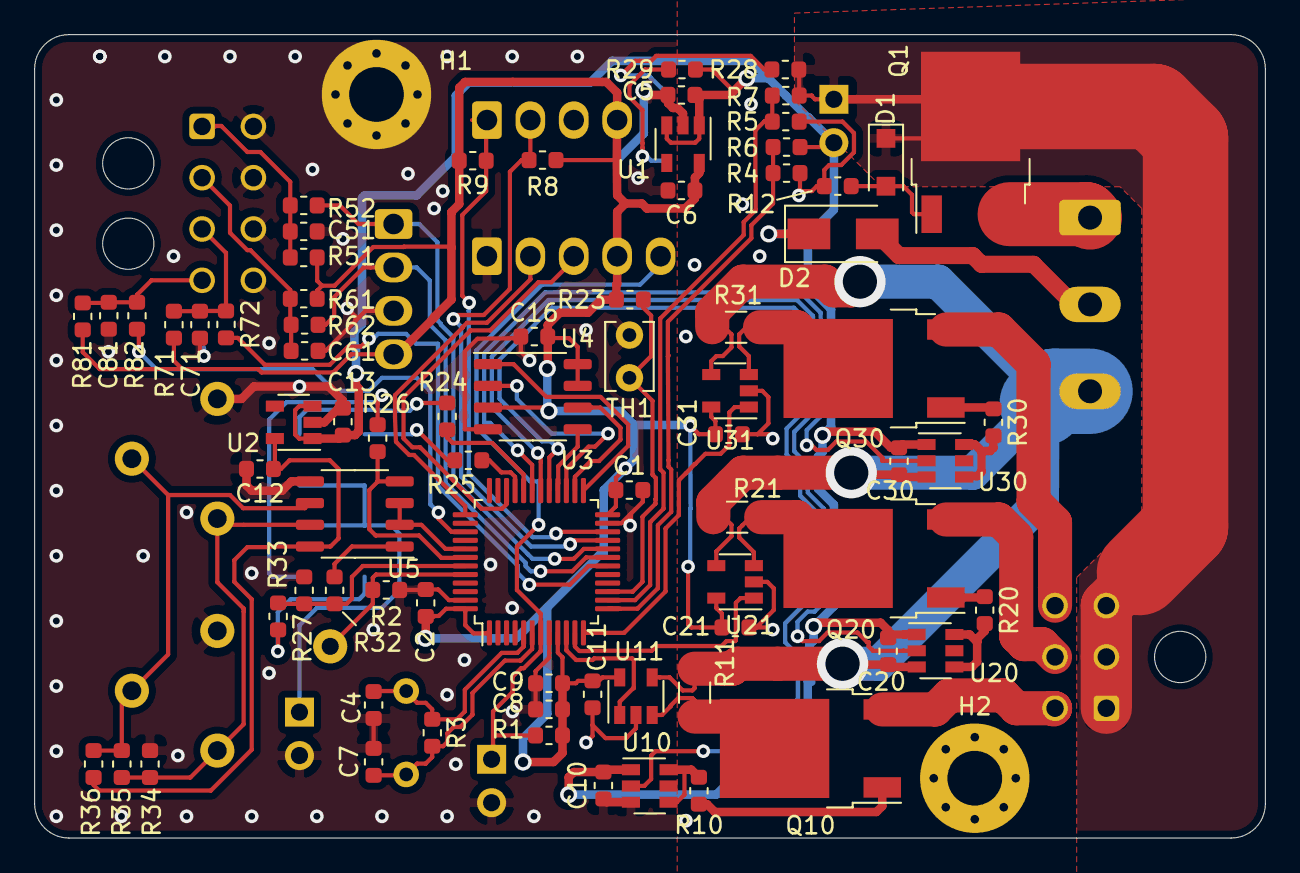
[picture p9: board LED_driver.kicad_pcb from above]

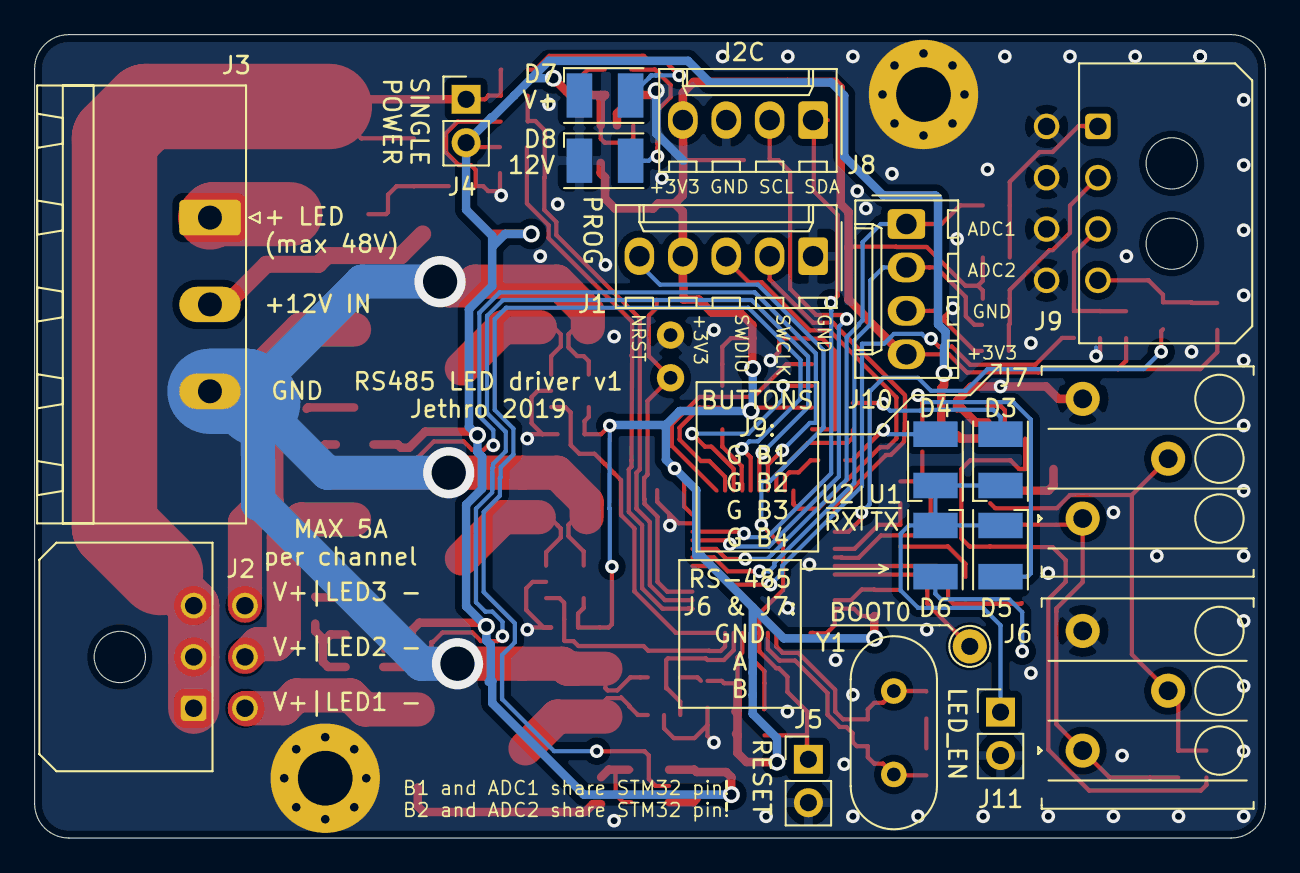
[picture p10: board LED_driver.kicad_pcb from below]

Board: 2 copper layers, 72.0 x 47.0 mm, 96 parts (19 on the bottom side), 64 nets.
