xtompok/LED_driver/sw_v3/LED_driver.ioc

Mcu.UserName=STM32G070CBTx
PA0.Signal=ADC1_IN0
PA1.Signal=ADC1_IN1
PA13.Signal=SYS_SWDIO
PA14-BOOT0.Signal=SYS_SWCLK
PA2.Signal=ADC1_IN2
PA6.Signal=S_TIM3_CH1
PA7.Signal=S_TIM3_CH2
PA8.Signal=S_TIM1_CH1
PA9.Signal=S_TIM1_CH2
PB0.Signal=S_TIM3_CH3
PB1.Signal=USART3_DE
PB10.Signal=USART3_TX
PB11.Signal=USART3_RX
PB14.Signal=GPIO_Input
PB15.Signal=GPIO_Input
PB6.Signal=USART1_TX
PB7.Signal=USART1_RX
PB8.Signal=GPIO_Output
PB9.Signal=GPIO_Output
PC6.Signal=GPIO_Input
