xtompok/LED_driver/(commit log)

2020-01-03 First version of LED driver.
    [LED_driver.kicad_pcb, LED_driver.sch]
2020-03-21 Prototype version v1.
    [LED_driver.kicad_pcb, LED_driver.sch, LED_driver_BOM.ods]
2021-04-25 Second version of the driver.
    [LED_driver2.kicad_pcb, LED_driver2.sch]
2021-05-24 Added testing firmware with working ADC.
2021-05-26 Working ADC DMA.
2024-09-14 Added schematic and started placement for 3rd version.
    [LED_driver3.kicad_pcb, LED_driver3.kicad_sch, driver.kicad_sch, rs485.kicad_sch]
2024-09-17 Silkscreen finished, bugfixes.
    [LED_driver3.kicad_pcb, LED_driver3.kicad_sch]
2024-10-05 Added LCSC numbers.
    [LED_driver3.kicad_sch, driver.kicad_sch]
